polymetric/proto-nano/Proto_Nano_BOM.ods

Qty. | Ref. Des. | Val. | Description | Price/Pkg. | Pkg. Sz. | Price
1 |  | PCB | PCB | $5.00 | 3 | $1.67
3 | C4 C5 C7 | 1uF | 0603 1uF ceramic capacitor >5V | $1.97 | 100 | $0.06
5 | C1 C10 C2 C3 C6 | 100nF | 0603 100nF ceramic capacitor >5V | $1.95 | 100 | $0.10
2 | C8 C9 | 4.7uF/T | 1206 4.7uF tantalum capacitor >5V | $2.78 | 100 | $0.06
1 | D1 | 1N5817 | 1N5817 diode in SOD-123 package | $1.06 | 100 | $0.01
1 | D2 D3 D4 D5 | TX | 0603 Red LED | $0.49 | 100 | $0.00
1 | F1 | MF-MSMF050-2 500mA | MF-MSMF050-2 500mA resettable polyfuse in 1812 package | $1.20 | 20 | $0.06
0 | J1 | USB | Molex 105017-0001 micro USB connector | $7.63 | 10 | $0.00
1 | J2 | ICSP header | 2x3 0.1” male pin header | $0.00 | 1 | $0.00
7 | R1 R2 R3 R4 R5 R6 R7 | 1K | 0603 1K resistor | $0.88 | 100 | $0.06
1 | SW1 | RESET | 3.6x6 SMD rectangular microswitch | $0.80 | 50 | $0.02
1 | U1 | LM1117-5.0 | Texas Instruments LM1117 5V in SOT-223 package | $2.30 | 100 | $0.02
1 | U2 | CH340G | CH340G in SOP-16 package (pitch 1.27mm) | $1.88 | 5 | $0.38
1 | U3 | ATMEGA328P-AU | ATMega 328P-AU in TQFP-32 package | $14.10 | 10 | $1.41
1 | XA1 | Arduino Headers | 1x16 0.1” male pin header | $0.00 | 1 | $0.00
1 | Y1 | 12MHz | 3.2x1.3 12MHz ceramic resonator | $1.75 | 10 | $0.18
1 | Y2 | 16MHz | 3.2x1.3 16MHz ceramic resonator | $2.88 | 20 | $0.14
 |  |  |  |  | Total: | $4.16
