polymetric/proto-nano/Proto_Nano_Assembly.pdf

# Proto Nano Assembly

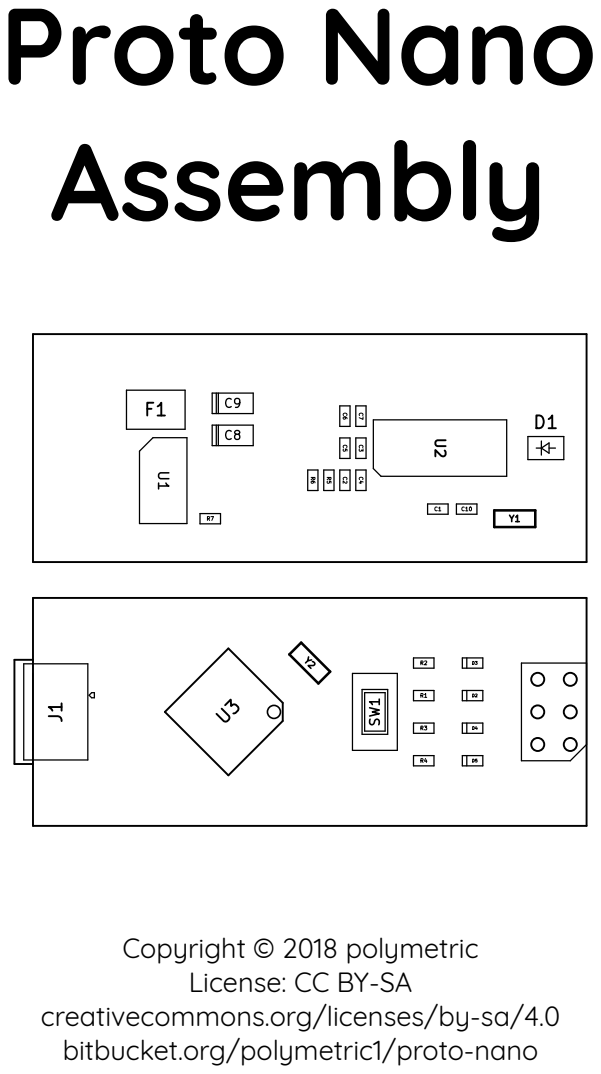
[picture p1: page 1]

Copyright © 2018 polymetric
License: CC BY-SA

creativecommons.org/licenses/by-sa/4.0
bitbucket.org/polymetric1/proto-nano
