polymetric/proto-nano/Proto_Nano.pdf

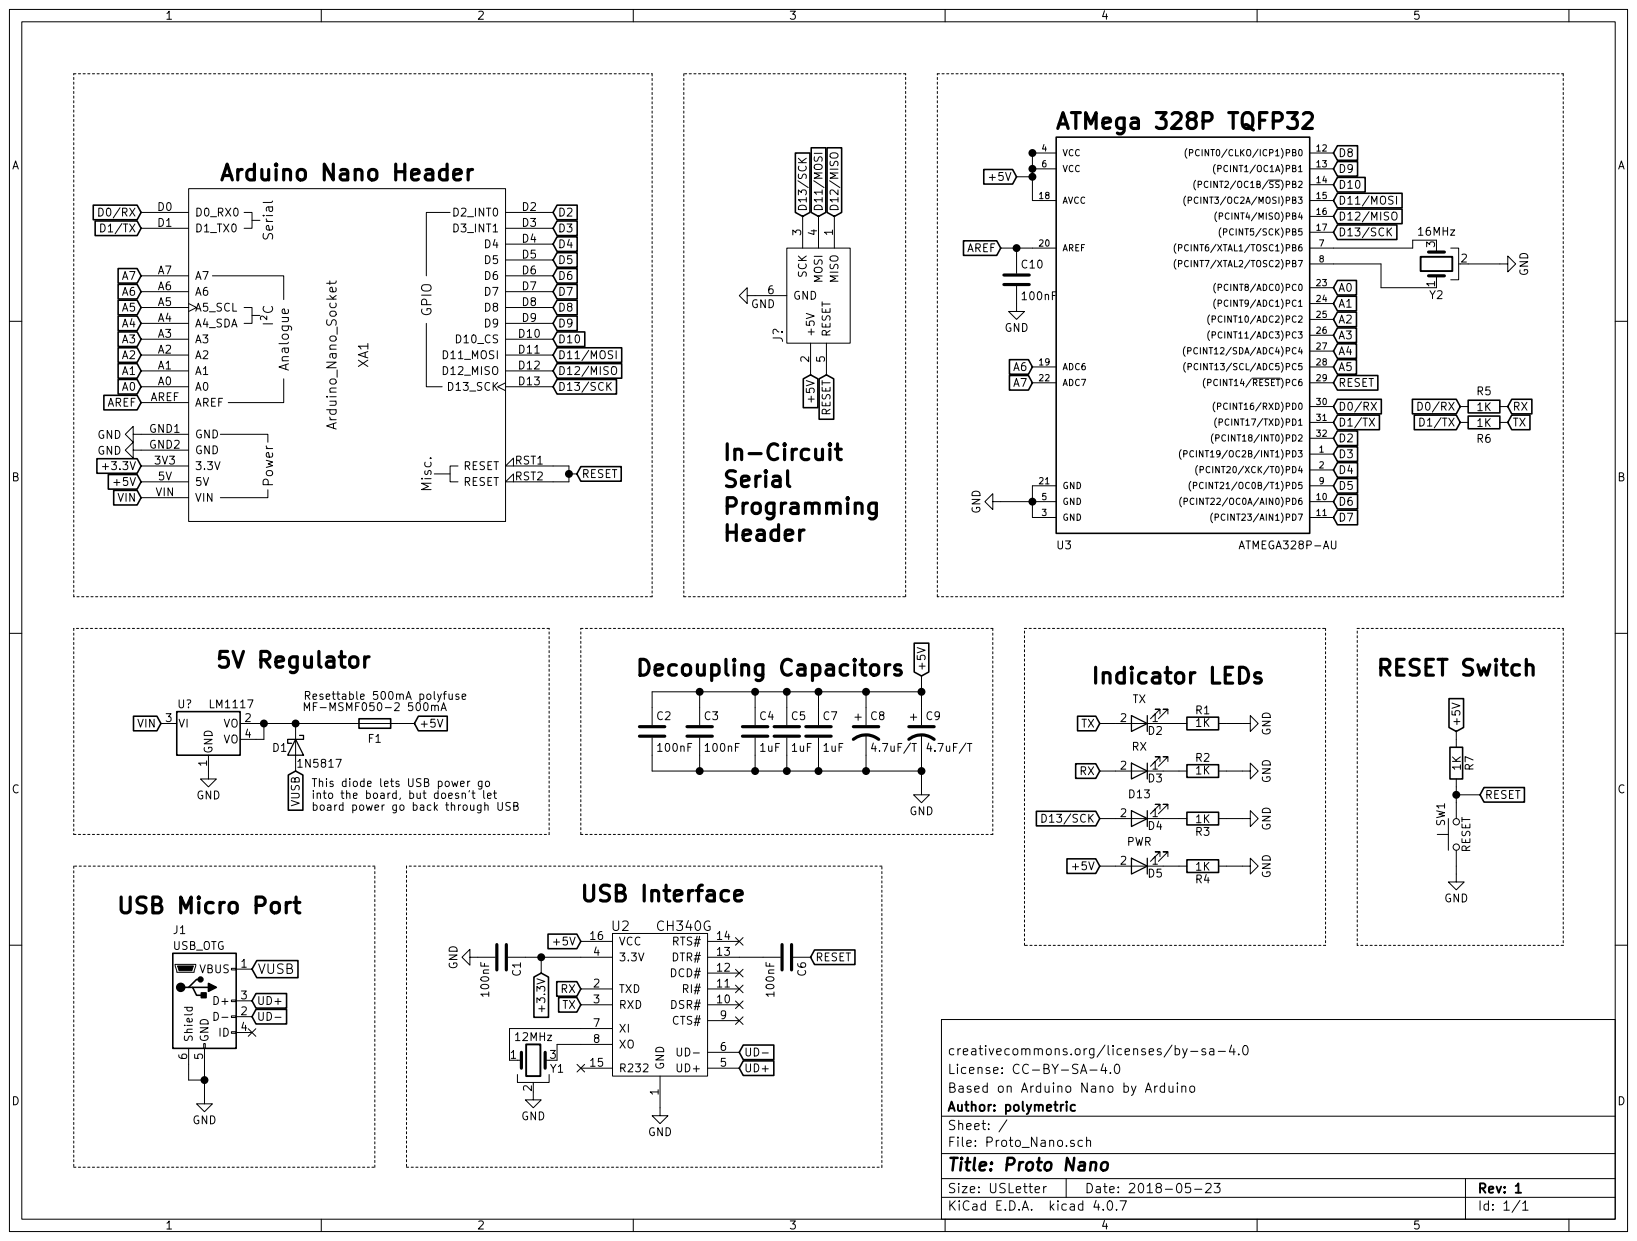
[picture p2: page 1]
