polymetric/proto-nano/Proto_Nano.kicad_pcb

## KiCad design Proto_Nano.kicad_pcb (2018-06-08)

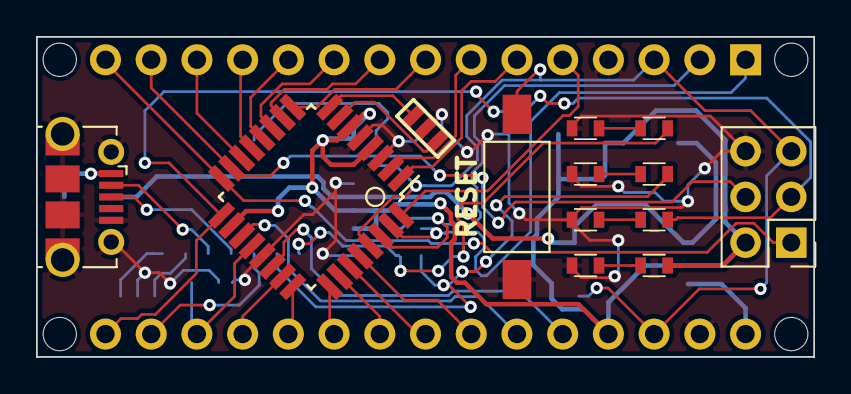
[picture p3: board Proto_Nano.kicad_pcb from above]

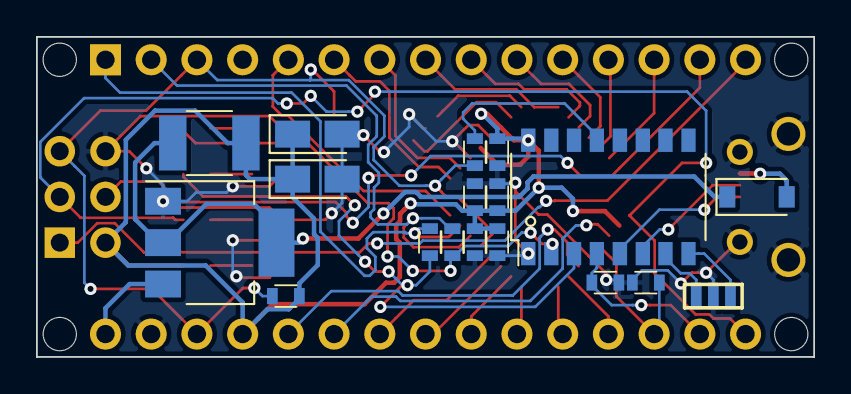
[picture p4: board Proto_Nano.kicad_pcb from below]

Board: 2 copper layers, 43.2 x 17.8 mm, 32 parts (18 on the bottom side), 43 nets.

Parts:
C1, C2, C3, C6, C10: 100nF; C_0603
C4, C5, C7: 1uF; C_0603
C8, C9: 4.7uF/T; CP_Tantalum_Case-A_EIA-3216-18_Reflow
D1: 1N5817; D_SOD-123
D2: TX; LED_0603
D3: RX; LED_0603
D4: D13; LED_0603
D5: PWR; LED_0603
F1: MF-MSMF050-2 500mA; 1812_PTC_Fuse
J1: USB_OTG; USB_Micro-B_Molex-105017-0001
J2: ICSP_Header; Pin_Header_Straight_2x03_Pitch2.54mm
R1, R2, R3, R4, R5, R6, R7: 1K; R_0603
SW1: RESET; SW_SPST_FSMSM
U1: LM1117-5.0; SOT-223
U2: CH340G; SOP-16_4.4x10.4mm_Pitch1.27mm
U3: ATMEGA328P-AU; TQFP-32_7x7mm_Pitch0.8mm
XA1: Arduino_Nano_Socket; Arduino_Nano_Shield
Y1: 12MHz; 1.3x3.2_resonator
Y2: 16MHz; 1.3x3.2_resonator

Connections:
+3.3V: C1.1, U2.4, XA1.3V3
+5V: C2.1, C3.1, C4.1, C5.1, C7.1, C8.1, C9.1, D5.2, F1.2, J2.2, R7.1, U2.16, U3.4, U3.6, U3.18, XA1.5V
A0: U3.23, XA1.A0
A1: U3.24, XA1.A1
A2: U3.25, XA1.A2
A3: U3.26, XA1.A3
A4: U3.27, XA1.A4
A5: U3.28, XA1.A5
A6: U3.19, XA1.A6
A7: U3.22, XA1.A7
AREF: C10.1, U3.20, XA1.AREF
D0/RX: R5.2, U3.30, XA1.D0
D1/TX: R6.2, U3.31, XA1.D1
D2: U3.32, XA1.D2
D3: U3.1, XA1.D3
D4: U3.2, XA1.D4
D5: U3.9, XA1.D5
D6: U3.10, XA1.D6
D7: U3.11, XA1.D7
D8: U3.12, XA1.D8
D9: U3.13, XA1.D9
D10: U3.14, XA1.D10
D11/MOSI: J2.4, U3.15, XA1.D11
D12/MISO: J2.1, U3.16, XA1.D12
D13/SCK: D4.2, J2.3, U3.17, XA1.D13
GND: C1.2, C2.2, C3.2, C4.2, C5.2, C7.2, C8.2, C9.2, C10.2, J1.5, J1.6, J2.6, R1.2, R2.2, R3.1, R4.1, SW1.1, U1.1, U2.1, U3.3, U3.5, U3.21, XA1.GND1, XA1.GND2, Y1.2, Y2.2
unnamed: C6.2, U2.13
unnamed: D1.1, F1.1, U1.2, U1.4
unnamed: D2.1, R1.1
unnamed: D3.1, R2.1
unnamed: D4.1, R3.2
unnamed: D5.1, R4.2
unnamed: U2.7, Y1.1
unnamed: U2.8, Y1.3
unnamed: U3.7, Y2.3
unnamed: U3.8, Y2.1
RESET: C6.1, J2.5, R7.2, SW1.2, U3.29, XA1.RST1, XA1.RST2
RX: D3.2, R5.1, U2.2
TX: D2.2, R6.1, U2.3
UD+: J1.3, U2.5
UD-: J1.2, U2.6
VIN: U1.3, XA1.VIN
VUSB: D1.2, J1.1
