polymetric/proto-nano/(commit log)

2018-05-30 add gerbers
    [Proto_Nano-B.Cu.gbr, Proto_Nano-B.Mask.gbr, Proto_Nano-B.Paste.gbr, Proto_Nano-B.SilkS.gbr, Proto_Nano-Edge.Cuts.gbr, Proto_Nano-F.Cu.gbr, Proto_Nano-F.Mask.gbr, Proto_Nano-F.Paste.gbr]
2018-05-30 move a via so it's not blocking some silkscreen text
    [Proto_Nano.kicad_pcb]
2018-06-08 zip gerbers and finish assembly diagram
    [Proto_Nano-B.Cu.gbr, Proto_Nano-B.Mask.gbr, Proto_Nano-B.Paste.gbr, Proto_Nano-B.SilkS.gbr, Proto_Nano-Edge.Cuts.gbr, Proto_Nano-F.Cu.gbr, Proto_Nano-F.Mask.gbr, Proto_Nano-F.Paste.gbr]
2018-06-08 fix a Thing on the schematic replace the symbol for the ICSP header with a more logical one, and move it to a different place in the schematic
    [Proto_Nano.sch]
