polymetric/proto-nano/(notices)

Notices in the files:
Proto_Nano.sch:
License: CC-BY-SA-4.0
